tsbogend/vbus-adapter/vbus-adapter.kicad_pcb

## KiCad design vbus-adapter.kicad_pcb (2026-03-06)

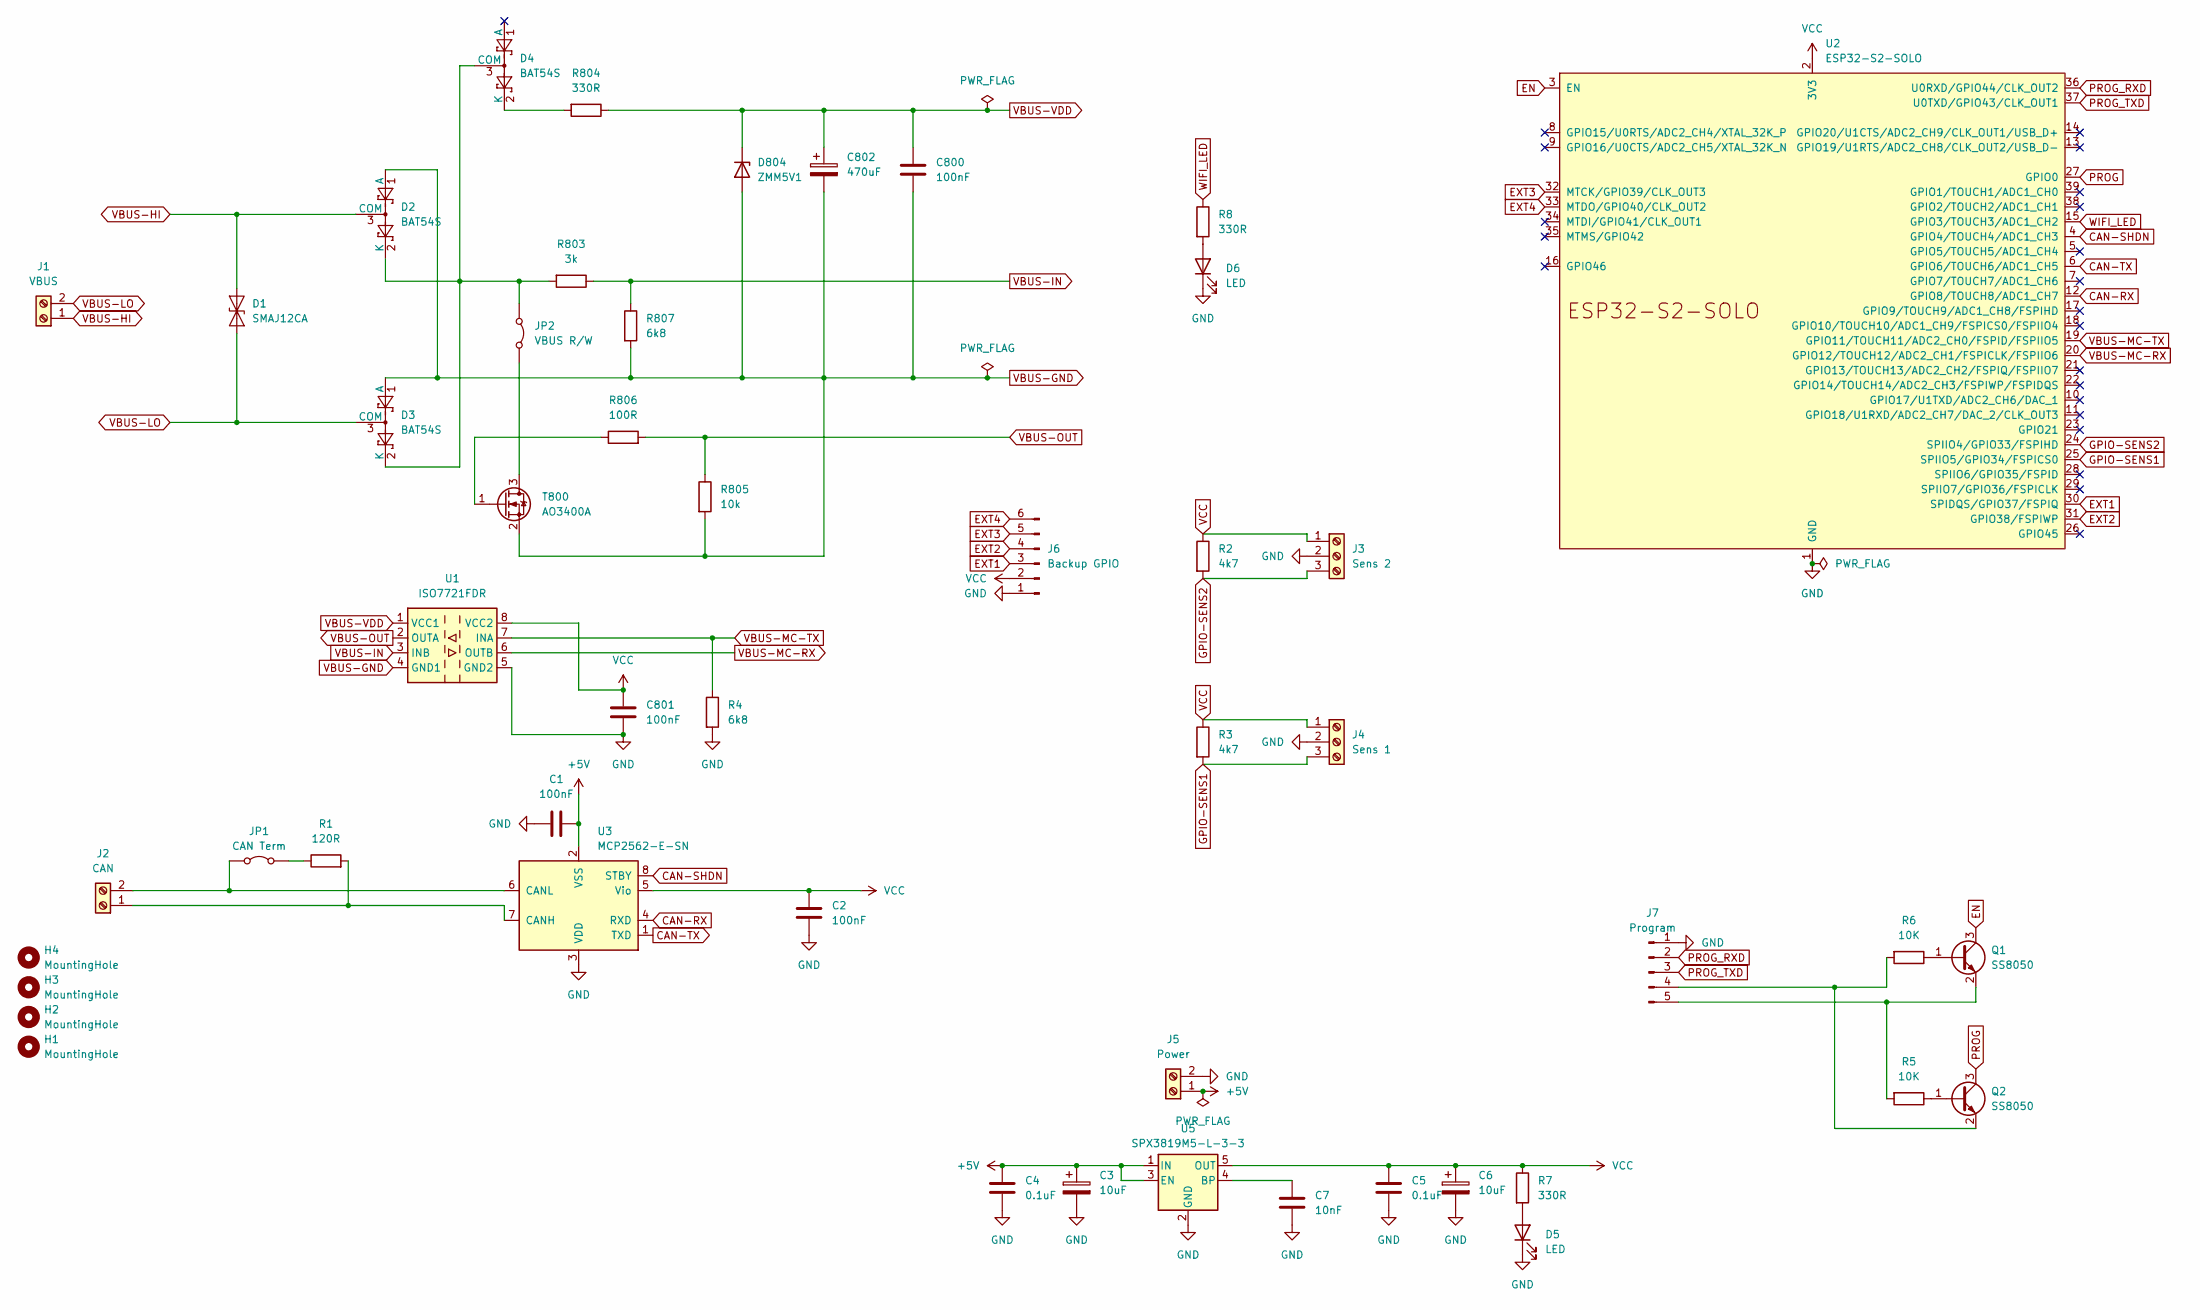
[picture p1: schematic vbus-adapter.kicad_sch]

Parts:
C1, C2, C800, C801: 100nF; C_0805_2012Metric_Pad1.18x1.45mm_HandSolder
C3, C6: 10uF; C_0805_2012Metric_Pad1.18x1.45mm_HandSolder
C4, C5: 0.1uF; C_0805_2012Metric_Pad1.18x1.45mm_HandSolder
C7: 10nF; C_0805_2012Metric_Pad1.18x1.45mm_HandSolder
C802: 470uF; CP_Elec_4x3.9
D1: SMAJ12CA; D_SMA
D2, D3, D4: BAT54S; SOT-23
D5, D6: LED; LED_0805_2012Metric_Pad1.15x1.40mm_HandSolder
D804: ZMM5V1; D_MiniMELF
H1, H2, H3, H4: MountingHole; MountingHole_3.2mm_M3_DIN965_Pad
J1: VBUS; TerminalBlock_Phoenix_MPT-0,5-2-2.54_1x02_P2.54mm_Horizontal
J2: CAN; TerminalBlock_Phoenix_MPT-0,5-2-2.54_1x02_P2.54mm_Horizontal
J3: Sens 2; TerminalBlock_Phoenix_MPT-0,5-3-2.54_1x03_P2.54mm_Horizontal
J4: Sens 1; TerminalBlock_Phoenix_MPT-0,5-3-2.54_1x03_P2.54mm_Horizontal
J5: Power; TerminalBlock_Phoenix_MPT-0,5-2-2.54_1x02_P2.54mm_Horizontal
J6: Backup GPIO; PinHeader_1x06_P2.54mm_Vertical
J7: Program; PinHeader_1x05_P2.54mm_Vertical
JP1: CAN Term; PinHeader_1x02_P2.54mm_Vertical
JP2: VBUS R/W; PinHeader_1x02_P2.54mm_Vertical
Q1, Q2: SS8050; SOT-23
R1: 120R; R_0805_2012Metric_Pad1.20x1.40mm_HandSolder
R2, R3: 4k7; R_0805_2012Metric_Pad1.20x1.40mm_HandSolder
R4, R807: 6k8; R_0805_2012Metric_Pad1.20x1.40mm_HandSolder
R5, R6: 10K; R_0805_2012Metric_Pad1.20x1.40mm_HandSolder
R7, R8, R804: 330R; R_0805_2012Metric_Pad1.20x1.40mm_HandSolder
R803: 3k; R_0805_2012Metric_Pad1.20x1.40mm_HandSolder
R805: 10k; R_0805_2012Metric_Pad1.20x1.40mm_HandSolder
R806: 100R; R_0805_2012Metric_Pad1.20x1.40mm_HandSolder
T800: AO3400A; SOT-23
U1: ISO7721FDR; SOIC-8_3.9x4.9mm_P1.27mm
U2: ESP32-S2-SOLO
U3: MCP2562-E-SN; SOIC-8_3.9x4.9mm_P1.27mm
U5: SPX3819M5-L-3-3; SOT-23-5

Connections:
+5V: C1.1, C3.1, C4.1, J5.1, U3.2 (VSS), U5.1 (IN), U5.3 (EN)
CAN-RX: U2.12 (GPIO8/TOUCH8/ADC1_CH7), U3.4 (RXD)
CAN-SHDN: U2.4 (GPIO4/TOUCH4/ADC1_CH3), U3.8 (STBY)
CAN-TX: U2.6 (GPIO6/TOUCH6/ADC1_CH5), U3.1 (TXD)
EN: Q1.3 (C), U2.3 (EN)
EXT1: J6.3, U2.30 (SPIDQS/GPIO37/FSPIQ)
EXT2: J6.4, U2.31 (GPIO38/FSPIWP)
EXT3: J6.5, U2.32 (MTCK/GPIO39/CLK_OUT3)
EXT4: J6.6, U2.33 (MTDO/GPIO40/CLK_OUT2)
GND: C1.2, C2.2, C3.2, C4.2, C5.2, C6.2, C7.2, C801.2, D5.1 (K), D6.1 (K), J3.2, J4.2, J5.2, J6.1, J7.1, R4.2, U1.5 (GND2), U2.1 (GND), U2.40 (GND), U2.41 (GND), U3.3 (VDD), U5.2 (GND)
GPIO-SENS1: J4.3, R3.2, U2.25 (SPIIO5/GPIO34/FSPICS0)
GPIO-SENS2: J3.3, R2.2, U2.24 (SPIIO4/GPIO33/FSPIHD)
unnamed: D2.2 (K), D3.2 (K), D4.3 (COM), JP2.1 (A), R803.2
unnamed: D4.2 (K), R804.2
unnamed: D5.2 (A), R7.2
unnamed: D6.2 (A), R8.2
unnamed: J2.1, R1.2, U3.7 (CANH)
unnamed: J2.2, JP1.1 (A), U3.6 (CANL)
unnamed: J7.4, Q2.2 (E), R6.2
unnamed: J7.5, Q1.2 (E), R5.2
unnamed: JP1.2 (B), R1.1
unnamed: JP2.2 (B), T800.3 (D)
unnamed: Q1.1 (B), R6.1
unnamed: Q2.1 (B), R5.1
unnamed: R806.1, T800.1 (G)
unnamed: C7.1, U5.4 (BP)
PROG: Q2.3 (C), U2.27 (GPIO0)
PROG_RXD: J7.2, U2.36 (U0RXD/GPIO44/CLK_OUT2)
PROG_TXD: J7.3, U2.37 (U0TXD/GPIO43/CLK_OUT1)
VBUS-GND: C800.2, C802.2, D2.1 (A), D3.1 (A), D804.2 (A), R805.2, R807.2, T800.2 (S), U1.4 (GND1)
VBUS-HI: D1.1 (A1), D2.3 (COM), J1.1
VBUS-IN: R803.1, R807.1, U1.3 (INB)
VBUS-LO: D1.2 (A2), D3.3 (COM), J1.2
VBUS-MC-RX: U1.6 (OUTB), U2.20 (GPIO12/TOUCH12/ADC2_CH1/FSPICLK/FSPIIO6)
VBUS-MC-TX: R4.1, U1.7 (INA), U2.19 (GPIO11/TOUCH11/ADC2_CH0/FSPID/FSPIIO5)
VBUS-OUT: R805.1, R806.2, U1.2 (OUTA)
VBUS-VDD: C800.1, C802.1, D804.1 (K), R804.1, U1.1 (VCC1)
VCC: C2.1, C5.1, C6.1, C801.1, J3.1, J4.1, J6.2, R2.1, R3.1, R7.1, U1.8 (VCC2), U2.2 (3V3), U3.5 (Vio), U5.5 (OUT)
WIFI_LED: R8.1, U2.15 (GPIO3/TOUCH3/ADC1_CH2)

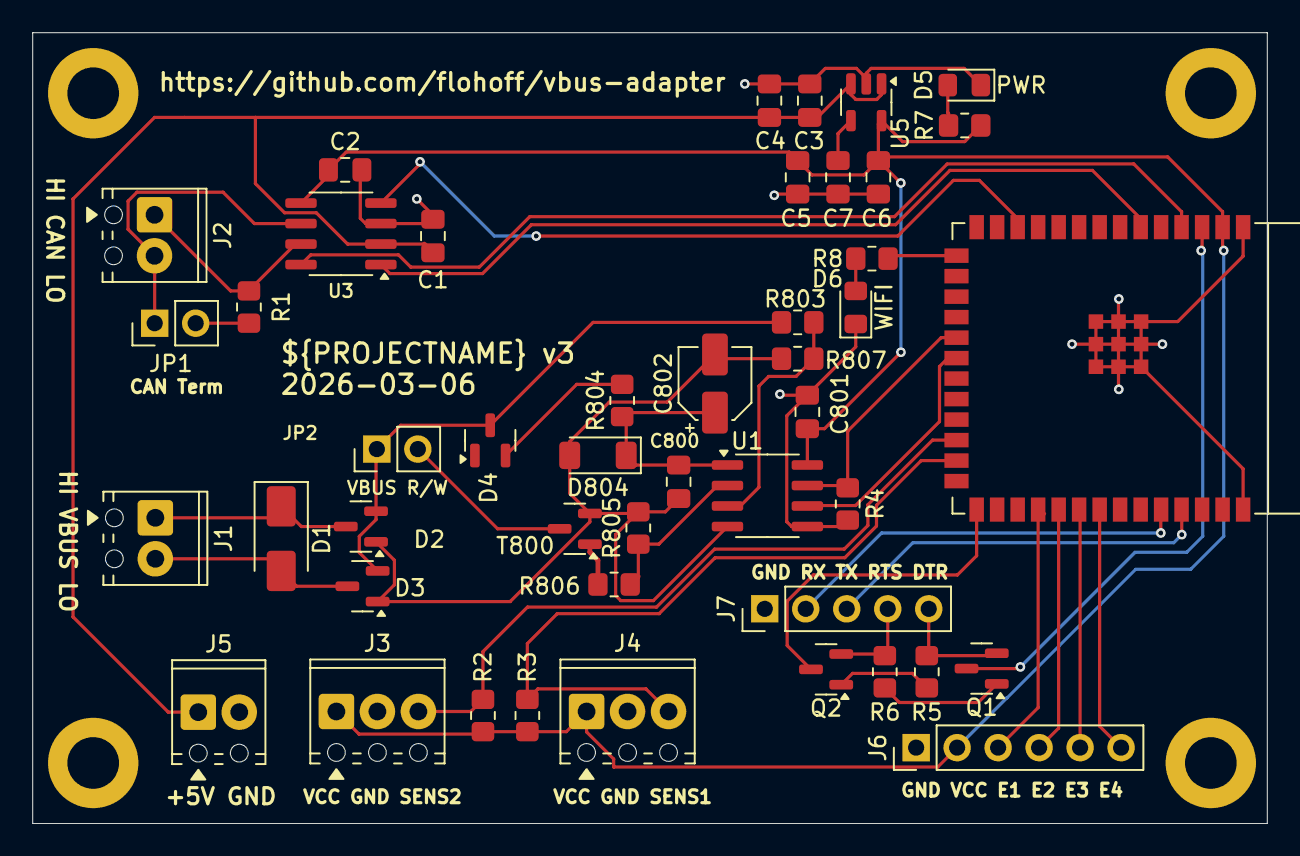
[picture p2: board vbus-adapter.kicad_pcb from above]

Board: 2 copper layers, 76.5 x 49.0 mm, 50 parts (0 on the bottom side), 39 nets.
