tsbogend/vbus-adapter/(commit log)

2026-01-22 Fix some issues
    - Use ISO7721FDR (Default Low output) so on disconnect of
    the ESP32 (Power loss) the VBUS will not be pulled to low
    e.g. bus disabled.
    - Add pull-down resistor to ISO input for TX
    - Add VBUS r/w jumper disconnecting the MOSFet drain from the VBUS
    [vbus-adapter.kicad_pcb, vbus-adapter.kicad_sch]
2026-03-05 Version 2
    [vbus-adapter.kicad_pcb, vbus-adapter.kicad_sch]
2026-03-06 Version 3 - Move GPIO for SENS, Add PWR/WIFI LED
    [vbus-adapter.kicad_pcb, vbus-adapter.kicad_sch]
